GrubbyLittleRaccoon/QT19-T19E1-derivative/images/receiverComparison.png

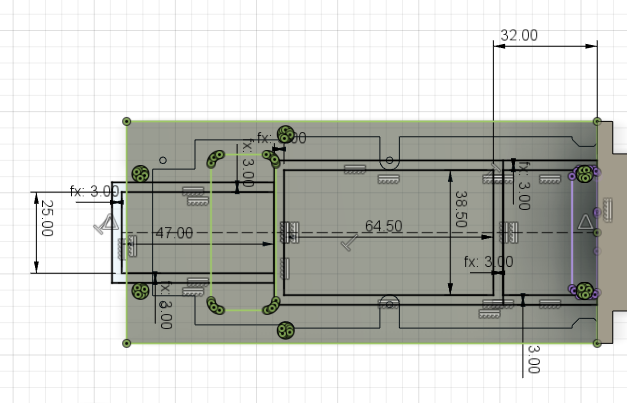
images/receiverComparison.png
