GrubbyLittleRaccoon/QT19-T19E1-derivative/qt19 stl files/Cages/Oldcages/Hy-Con-GammaMajor_Main_iFlightXE_PRO_9.5mm_covered.stl

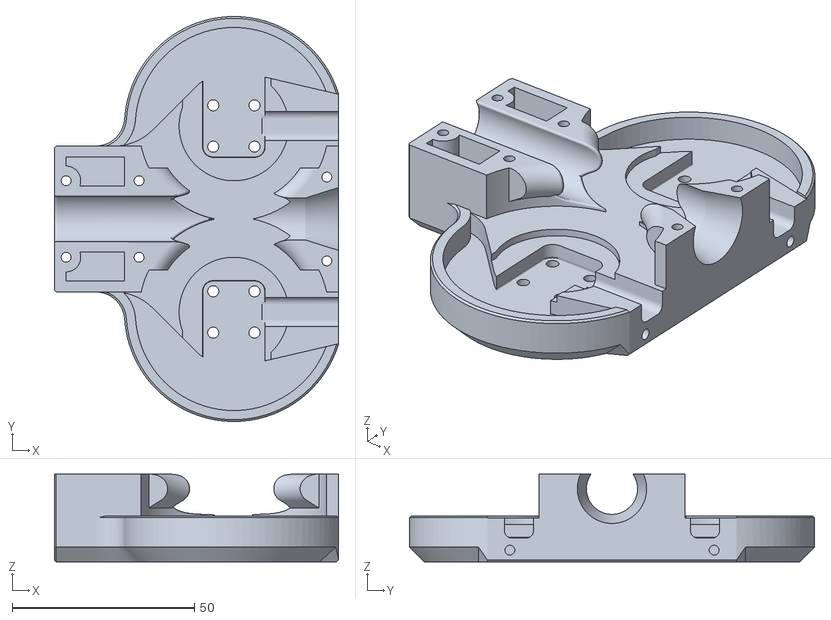
[picture p24: CAD file, 2022-11-29]
qt19 stl files/Cages/Oldcages/Hy-Con-GammaMajor_Main_iFlightXE_PRO_9.5mm_covered.stl
78.0 x 111.1 x 24.0
