GrubbyLittleRaccoon/QT19-T19E1-derivative/qt19 stl files/Cages/Hy-Con-GammaMajor_Main_iFlight_pro_9.0_ready_bcar.stl

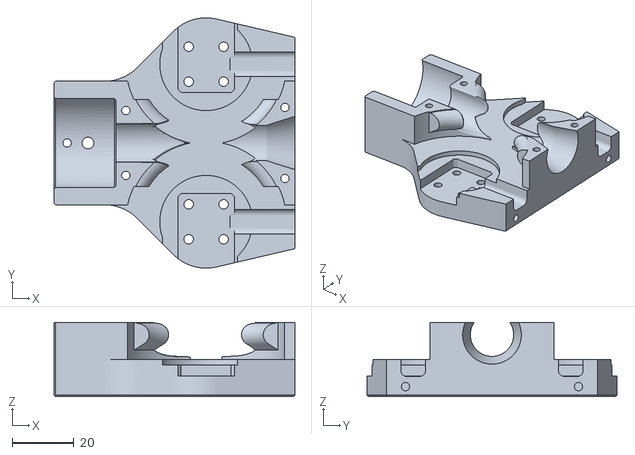
[picture p25: CAD file, 2023-09-17]
qt19 stl files/Cages/Hy-Con-GammaMajor_Main_iFlight_pro_9.0_ready_bcar.stl
78.0 x 81.0 x 24.0
