GrubbyLittleRaccoon/QT19-T19E1-derivative/qt19 stl files/Receiver/main receiver picatinny rail.stl

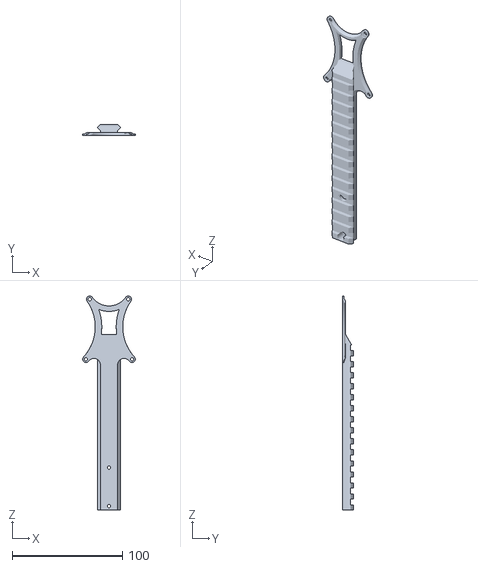
[picture p26: CAD file, 2022-11-29]
qt19 stl files/Receiver/main receiver picatinny rail.stl
48.0 x 10.3 x 194.5
