GrubbyLittleRaccoon/QT19-T19E1-derivative/GUI sight/sheetcurved.stl

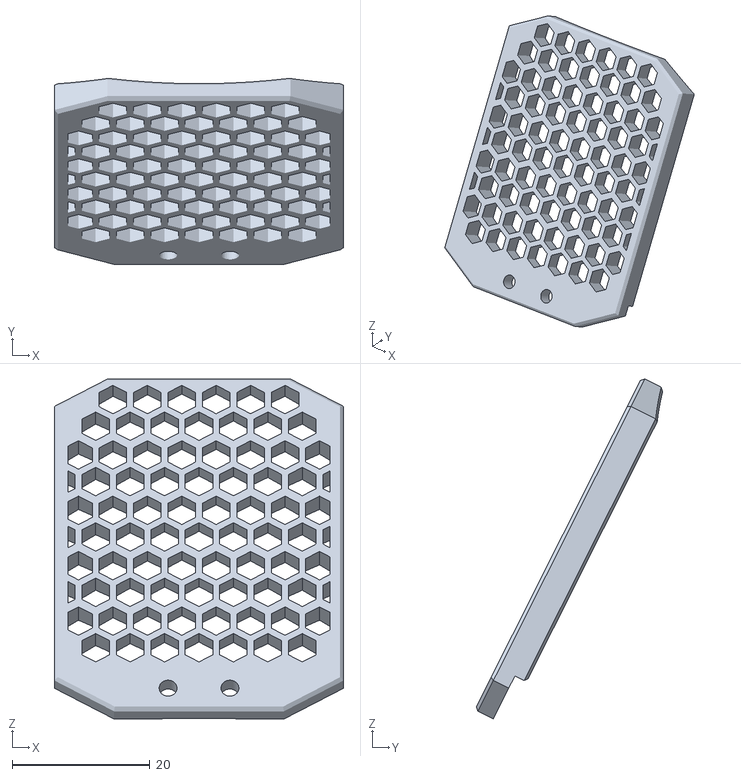
[picture p28: CAD file, 2022-11-29]
GUI sight/sheetcurved.stl
42.0 x 27.0 x 49.4
