GrubbyLittleRaccoon/QT19-T19E1-derivative/My stl edits/short breech edited no undercut.stl

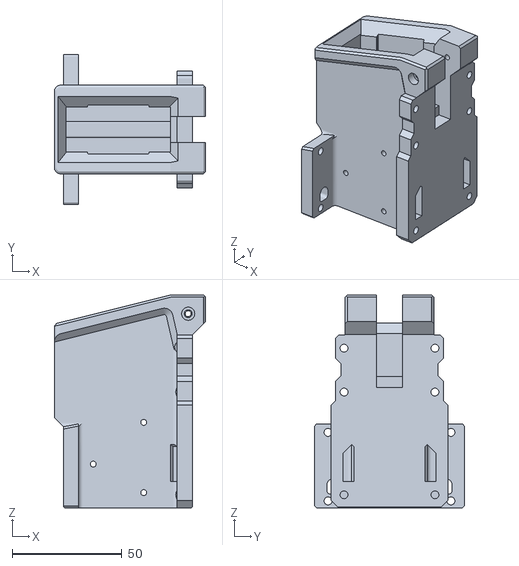
[picture p29: CAD file, 2022-11-29]
My stl edits/short breech edited no undercut.stl
69.0 x 68.4 x 97.0
