GrubbyLittleRaccoon/QT19-T19E1-derivative/qt19 stl files/Cages/Hy-Con-GammaMajor_toprail.stl

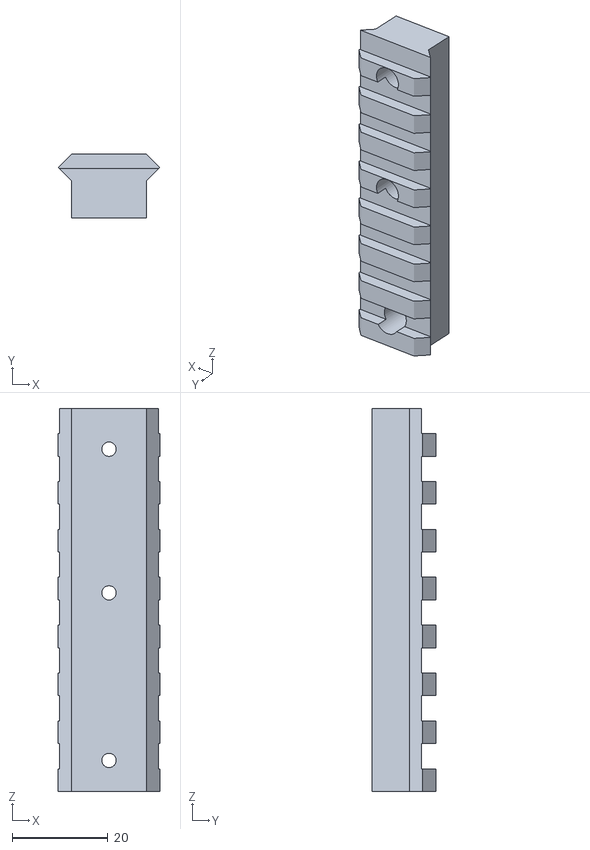
[picture p30: CAD file, 2023-09-17]
qt19 stl files/Cages/Hy-Con-GammaMajor_toprail.stl
21.2 x 13.3 x 80.0
