GrubbyLittleRaccoon/QT19-T19E1-derivative/qt19 stl files/Cages/Oldcages/Hy-Con_Wheels_iFlight_XE_PRO_9.0mm.stl

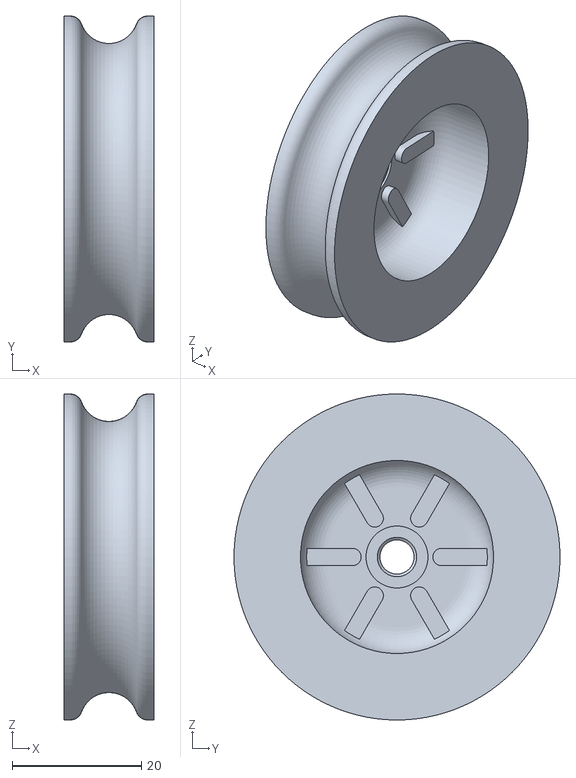
[picture p31: CAD file, 2022-11-29]
qt19 stl files/Cages/Oldcages/Hy-Con_Wheels_iFlight_XE_PRO_9.0mm.stl
14.0 x 50.5 x 50.5
