GrubbyLittleRaccoon/QT19-T19E1-derivative/qt19 stl files/Grip/QT19_Trigger_spaced.stl

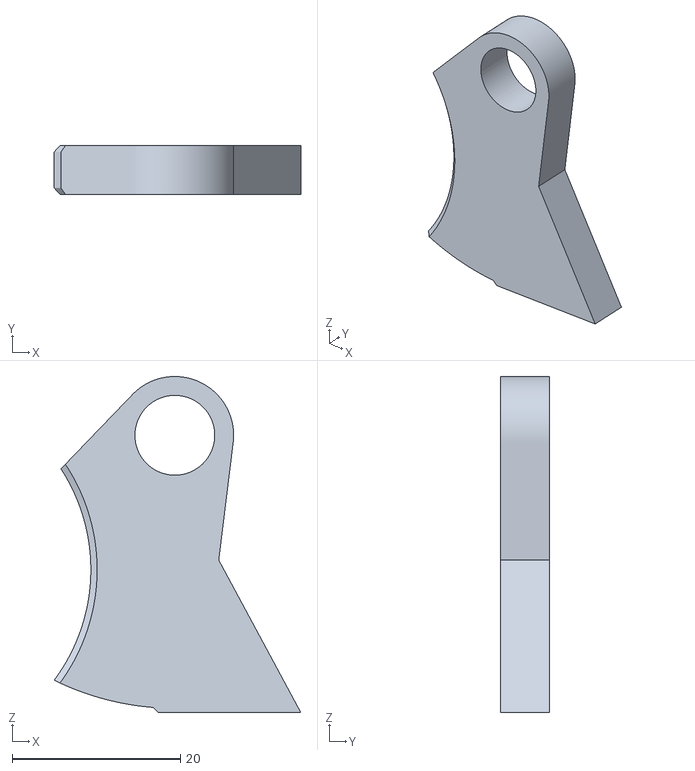
[picture p32: CAD file, 2023-09-17]
qt19 stl files/Grip/QT19_Trigger_spaced.stl
29.4 x 5.80 x 40.0
