GrubbyLittleRaccoon/QT19-T19E1-derivative/qt19 stl files/Magwell breech/QT19_ShortMagRelease_spaced.stl

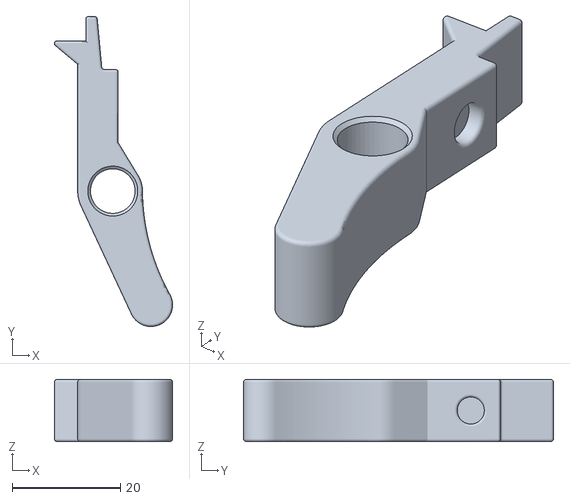
[picture p33: CAD file, 2023-09-17]
qt19 stl files/Magwell breech/QT19_ShortMagRelease_spaced.stl
21.9 x 57.4 x 11.5
