GrubbyLittleRaccoon/QT19-T19E1-derivative/qt19 stl files/Receiver/magreleaseblock.stl

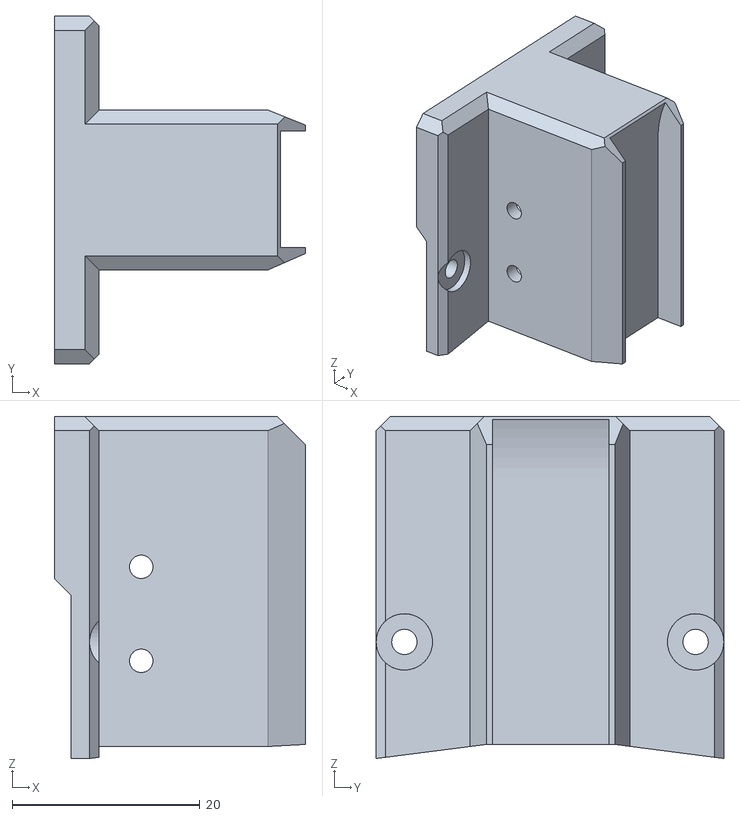
[picture p34: CAD file, 2023-09-19]
qt19 stl files/Receiver/magreleaseblock.stl
26.8 x 37.0 x 36.4
