GrubbyLittleRaccoon/QT19-T19E1-derivative/qt19 stl files/Top covers - probably redo these/polycarb_cover_cutguide.stl

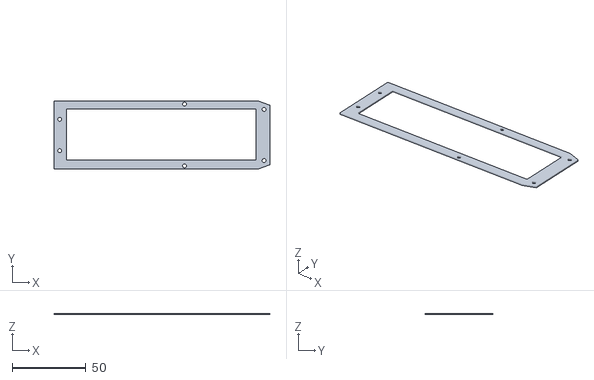
[picture p35: CAD file, 2022-11-29]
qt19 stl files/Top covers - probably redo these/polycarb_cover_cutguide.stl
146.5 x 46.4 x 1.00
