GrubbyLittleRaccoon/QT19-T19E1-derivative/GUI sight/top02.stl

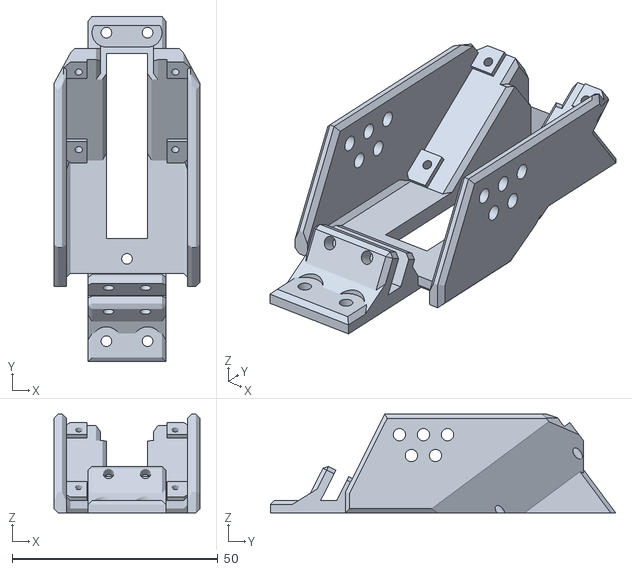
[picture p36: CAD file, 2022-11-29]
GUI sight/top02.stl
35.5 x 84.0 x 24.0
