GrubbyLittleRaccoon/QT19-T19E1-derivative/My stl edits/stock base.stl

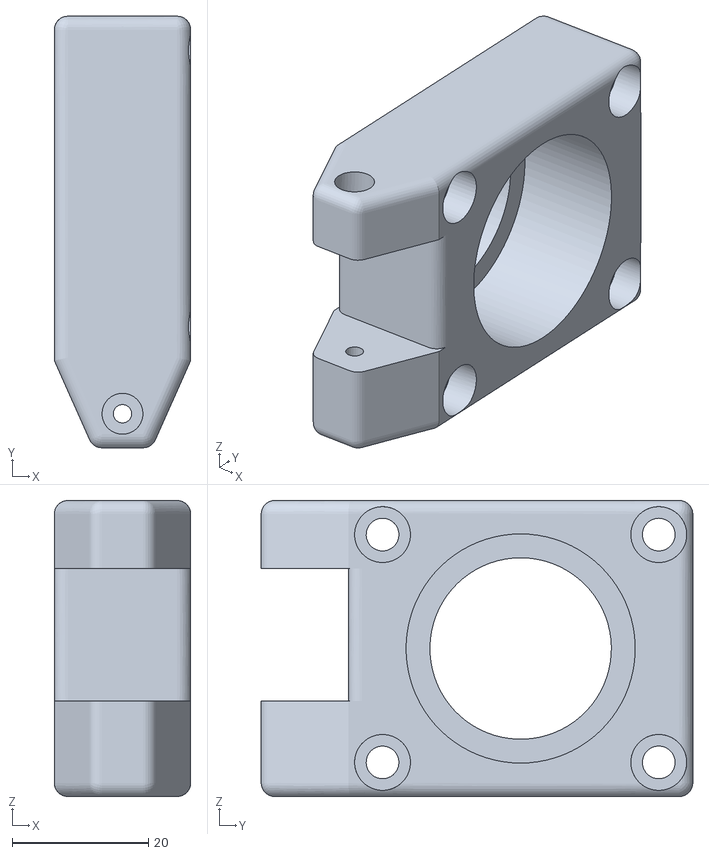
[picture p37: CAD file, 2022-11-29]
My stl edits/stock base.stl
20.0 x 63.3 x 43.4
