GrubbyLittleRaccoon/QT19-T19E1-derivative/qt19 stl files/Cages/Hy-Con-GammaMajor_Cover_BR2207S_undercut_bcar.stl

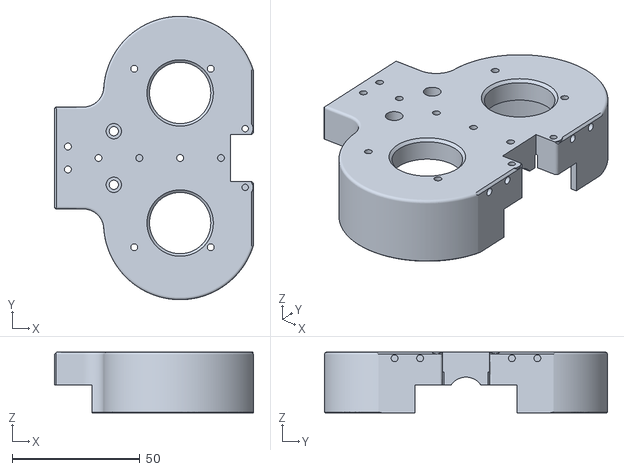
[picture p38: CAD file, 2023-09-17]
qt19 stl files/Cages/Hy-Con-GammaMajor_Cover_BR2207S_undercut_bcar.stl
78.0 x 111.1 x 23.8
