GrubbyLittleRaccoon/QT19-T19E1-derivative/qt19 stl files/Grip/QT19_Trigger_spacer.stl

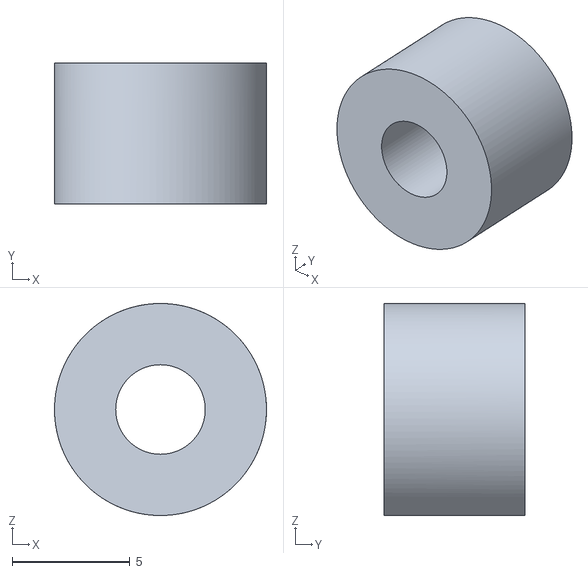
[picture p39: CAD file, 2023-09-17]
qt19 stl files/Grip/QT19_Trigger_spacer.stl
9.00 x 6.00 x 9.00
