GrubbyLittleRaccoon/QT19-T19E1-derivative/qt19 stl files/Magwell breech/QT19_ShortMagRelease_spacer.stl

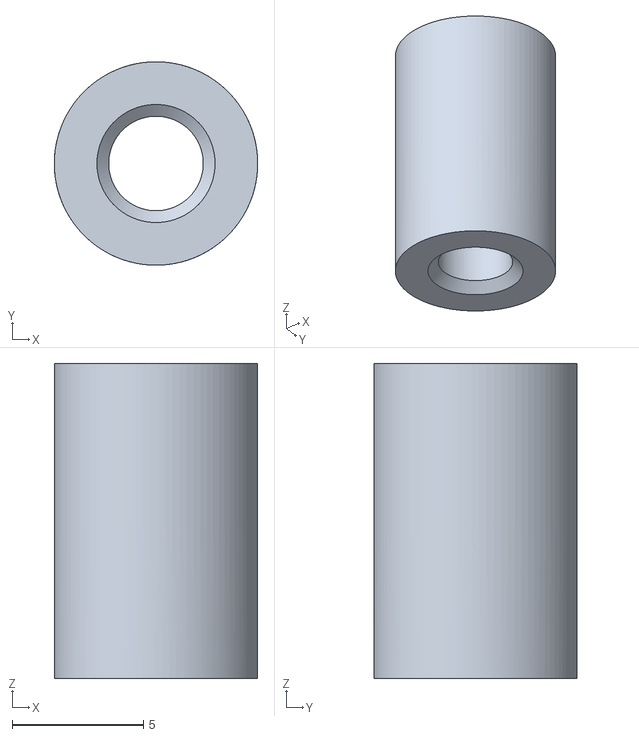
[picture p40: CAD file, 2023-09-17]
qt19 stl files/Magwell breech/QT19_ShortMagRelease_spacer.stl
7.75 x 7.75 x 12.0
