GrubbyLittleRaccoon/QT19-T19E1-derivative/qt19 stl files/Receiver/hexagonal solenoid pusher.stl

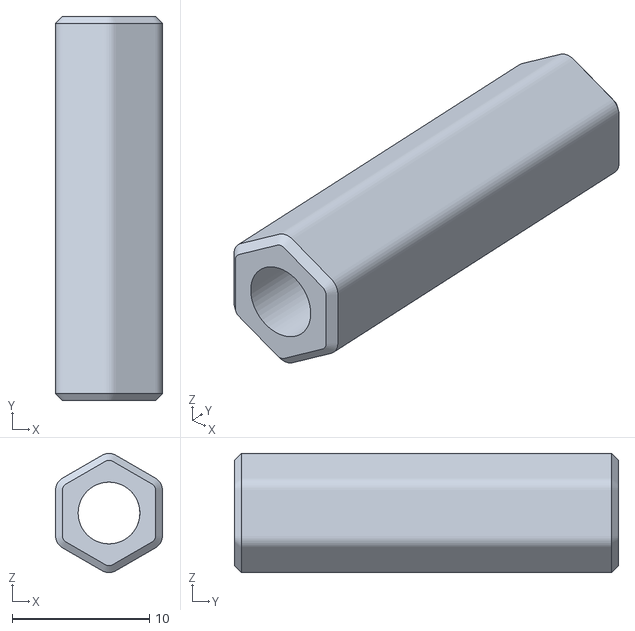
[picture p41: CAD file, 2022-11-29]
qt19 stl files/Receiver/hexagonal solenoid pusher.stl
7.79 x 28.0 x 8.69
