GrubbyLittleRaccoon/QT19-T19E1-derivative/qt19 stl files/Stock/printed stock tube pt1.stl

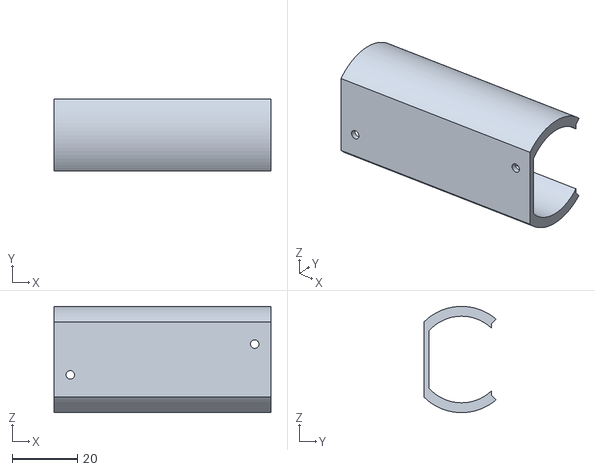
[picture p42: CAD file, 2022-11-29]
qt19 stl files/Stock/printed stock tube pt1.stl
66.4 x 22.1 x 32.5
