GrubbyLittleRaccoon/QT19-T19E1-derivative/qt19 stl files/Top covers - probably redo these/solenoid cover.stl

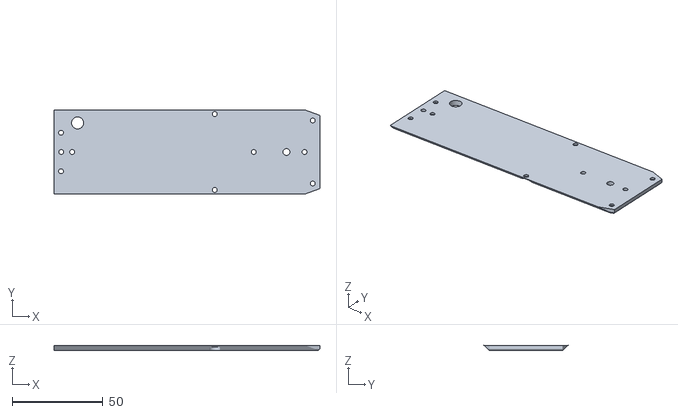
[picture p43: CAD file, 2022-11-29]
qt19 stl files/Top covers - probably redo these/solenoid cover.stl
146.5 x 46.4 x 3.00
