GrubbyLittleRaccoon/QT19-T19E1-derivative/GUI sight/sheet.stl

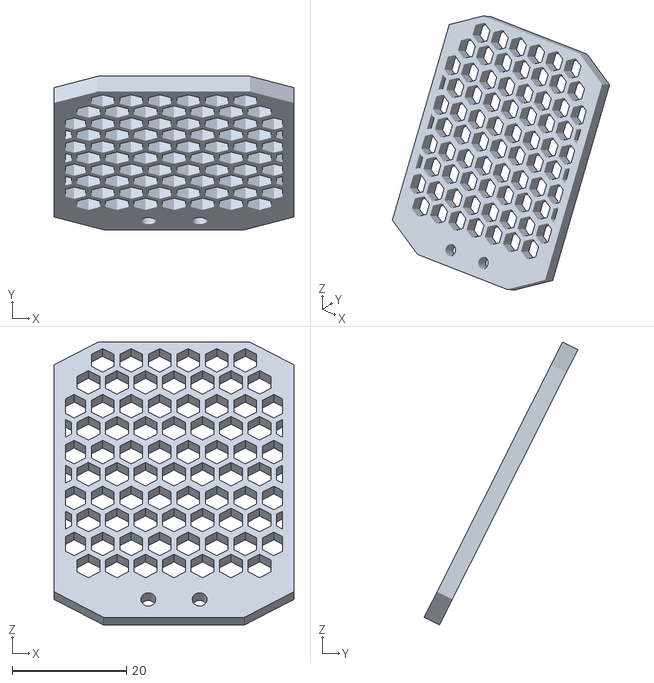
[picture p44: CAD file, 2022-11-29]
GUI sight/sheet.stl
42.0 x 26.9 x 49.6
