GrubbyLittleRaccoon/QT19-T19E1-derivative/My stl edits/charging slider.stl

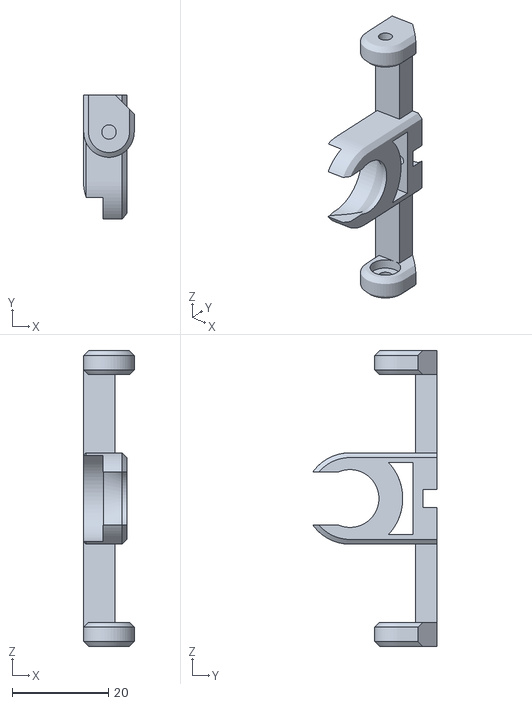
[picture p45: CAD file, 2022-11-29]
My stl edits/charging slider.stl
10.5 x 25.9 x 61.5
