GrubbyLittleRaccoon/QT19-T19E1-derivative/qt19 stl files/Cages/Oldcages/picatinny cage muzzle cosmetic barrel.stl

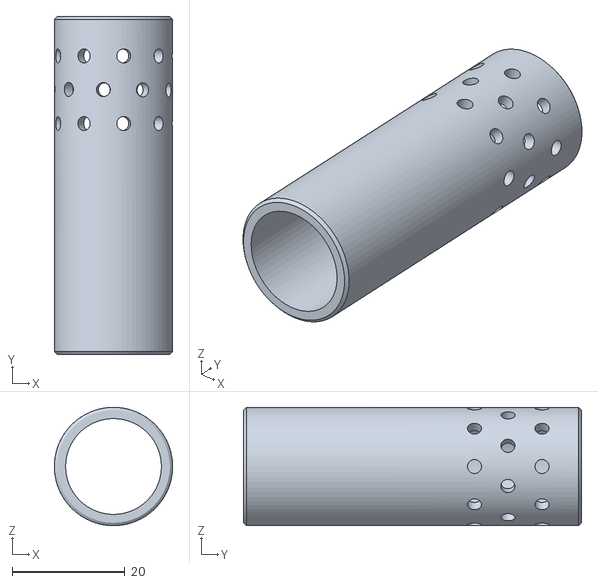
[picture p46: CAD file, 2022-11-29]
qt19 stl files/Cages/Oldcages/picatinny cage muzzle cosmetic barrel.stl
21.0 x 60.0 x 21.0
