GrubbyLittleRaccoon/QT19-T19E1-derivative/qt19 stl files/Grip/QT19_GripBase.stl

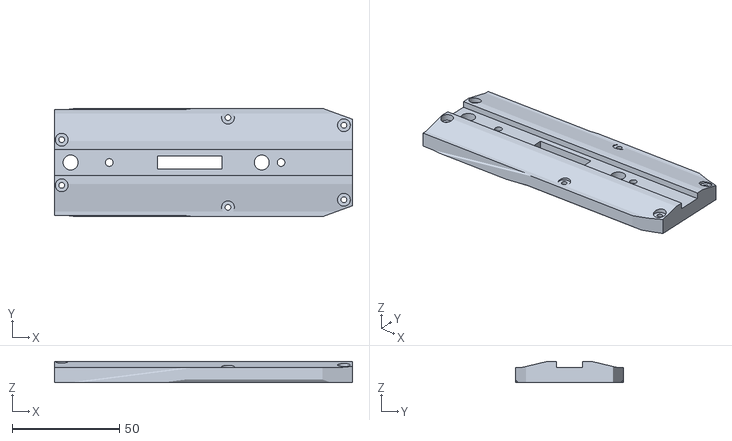
[picture p47: CAD file, 2022-11-29]
qt19 stl files/Grip/QT19_GripBase.stl
138.8 x 50.5 x 10.0
