GrubbyLittleRaccoon/QT19-T19E1-derivative/qt19 stl files/Magwell breech/QT19_ShortBreech.stl

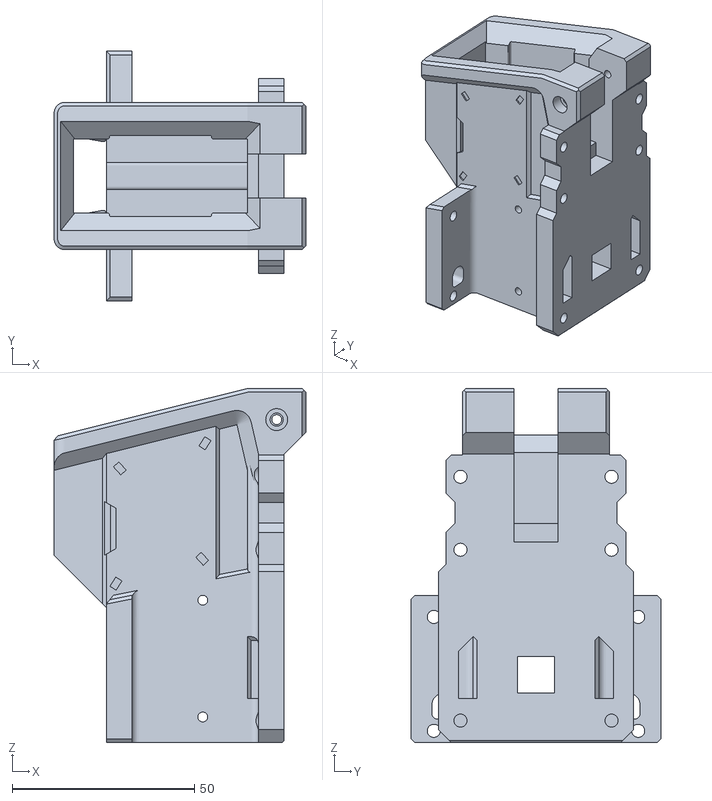
[picture p48: CAD file, 2022-11-29]
qt19 stl files/Magwell breech/QT19_ShortBreech.stl
69.0 x 68.4 x 97.0
