GrubbyLittleRaccoon/QT19-T19E1-derivative/qt19 stl files/Stock/QT19_Stock.stl

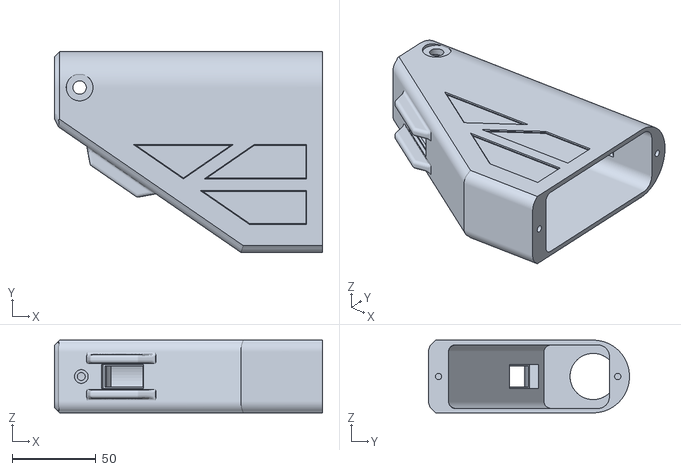
[picture p49: CAD file, 2022-11-29]
qt19 stl files/Stock/QT19_Stock.stl
160.0 x 120.0 x 43.4
