GrubbyLittleRaccoon/QT19-T19E1-derivative/qt19 stl files/Top covers - probably redo these/breech top cover 2.stl

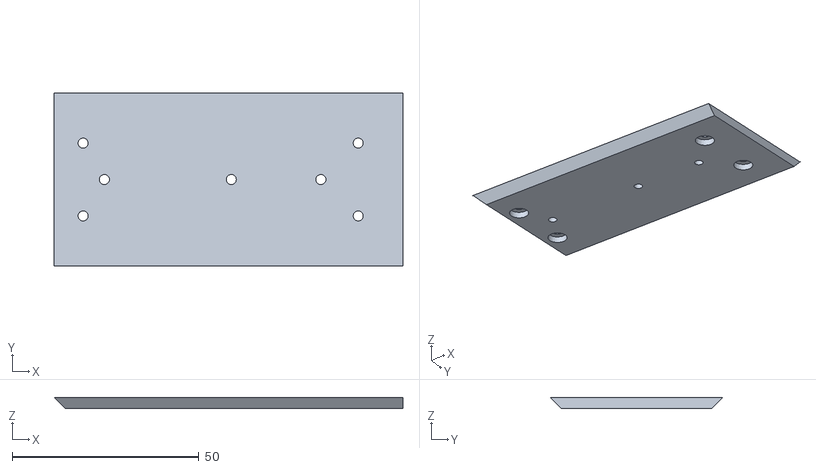
[picture p50: CAD file, 2022-11-29]
qt19 stl files/Top covers - probably redo these/breech top cover 2.stl
93.5 x 46.4 x 3.00
