GrubbyLittleRaccoon/QT19-T19E1-derivative/GUI sight/base02.stl

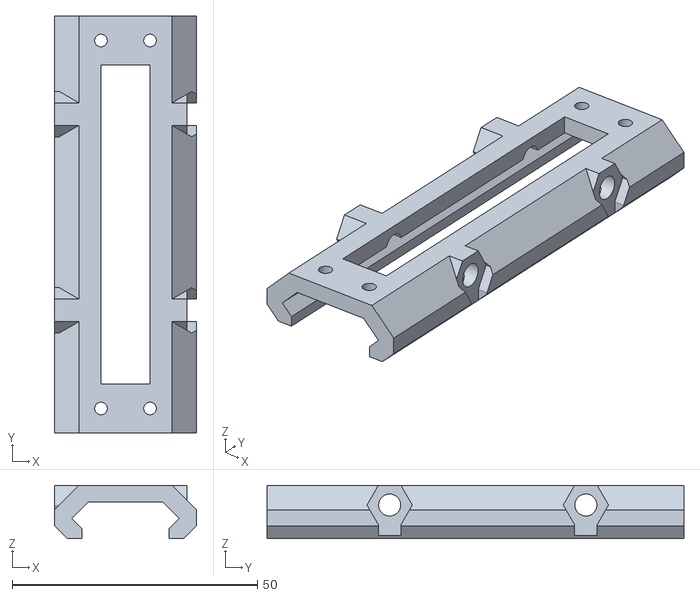
[picture p51: CAD file, 2022-11-29]
GUI sight/base02.stl
29.0 x 85.0 x 10.9
