GrubbyLittleRaccoon/QT19-T19E1-derivative/My stl edits/charging nub.stl

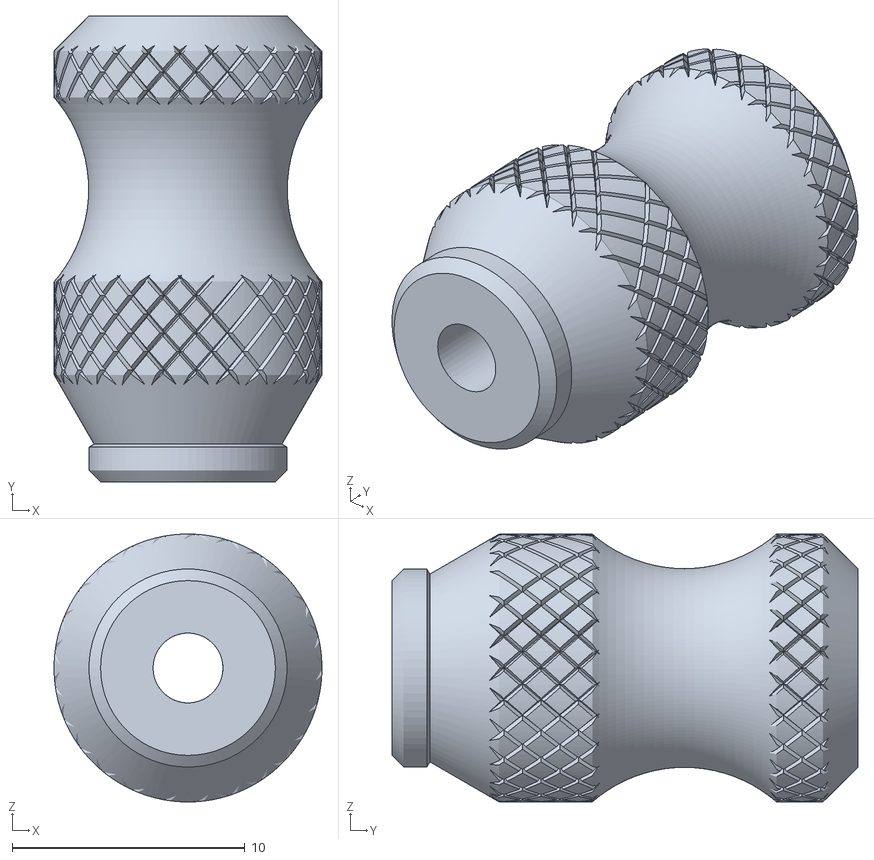
[picture p52: CAD file, 2022-11-29]
My stl edits/charging nub.stl
11.5 x 20.0 x 11.5
