GrubbyLittleRaccoon/QT19-T19E1-derivative/qt19 stl files/Cages/Hy-Con-insert muzzle.stl

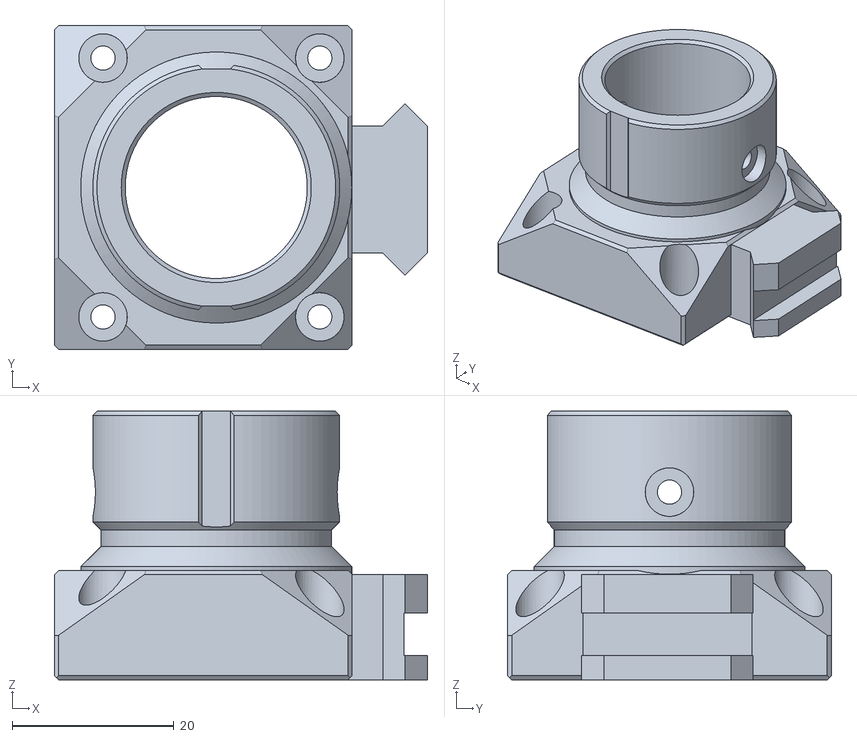
[picture p53: CAD file, 2023-09-17]
qt19 stl files/Cages/Hy-Con-insert muzzle.stl
46.1 x 40.0 x 33.2
