GrubbyLittleRaccoon/QT19-T19E1-derivative/qt19 stl files/Grip/QT19_GripPanelRight.stl

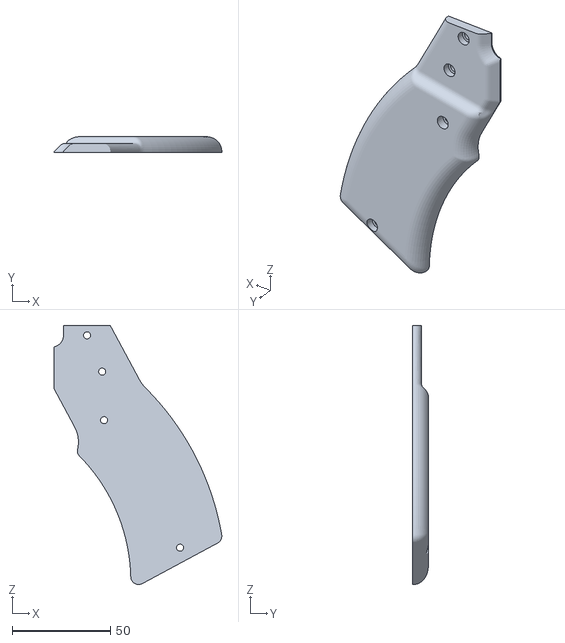
[picture p55: CAD file, 2022-11-29]
qt19 stl files/Grip/QT19_GripPanelRight.stl
85.3 x 8.00 x 131.7
