GrubbyLittleRaccoon/QT19-T19E1-derivative/qt19 stl files/Magwell breech/QT19_Short_Wirecover.stl

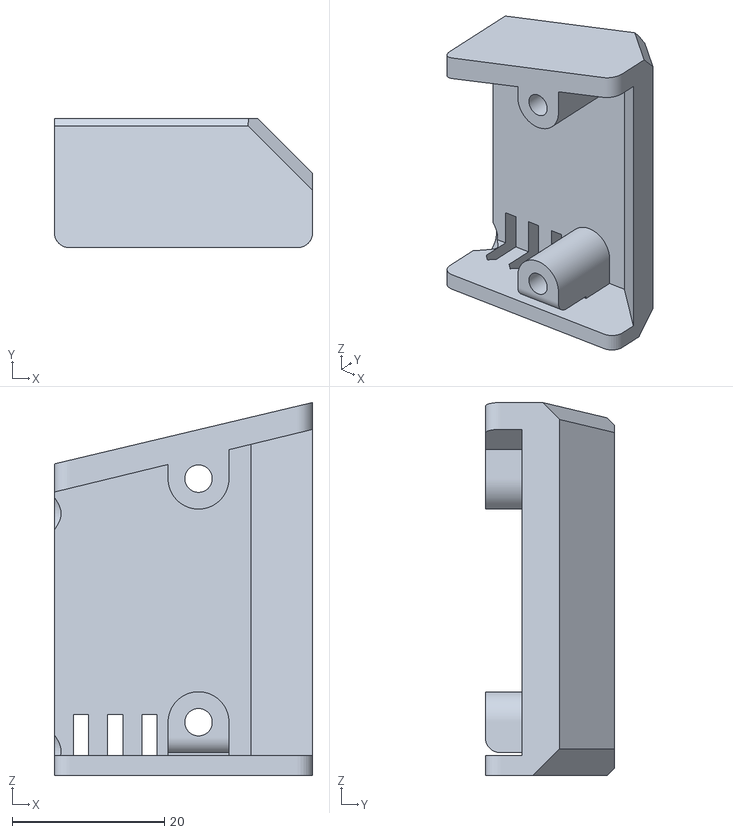
[picture p56: CAD file, 2022-11-29]
qt19 stl files/Magwell breech/QT19_Short_Wirecover.stl
34.0 x 17.0 x 49.0
