GrubbyLittleRaccoon/QT19-T19E1-derivative/qt19 stl files/Receiver/solenoid upper reciever.stl

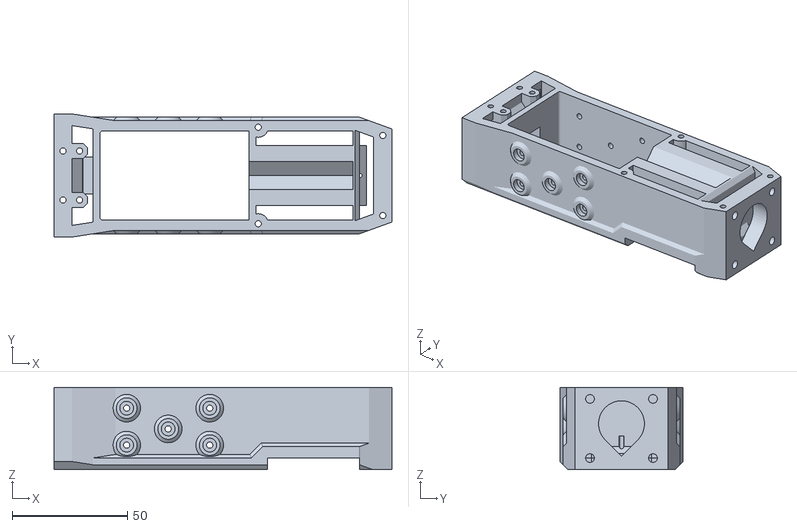
[picture p57: CAD file, 2022-11-29]
qt19 stl files/Receiver/solenoid upper reciever.stl
146.5 x 53.4 x 35.6
