GrubbyLittleRaccoon/QT19-T19E1-derivative/qt19 stl files/Stock/printed stock tube pt3.stl

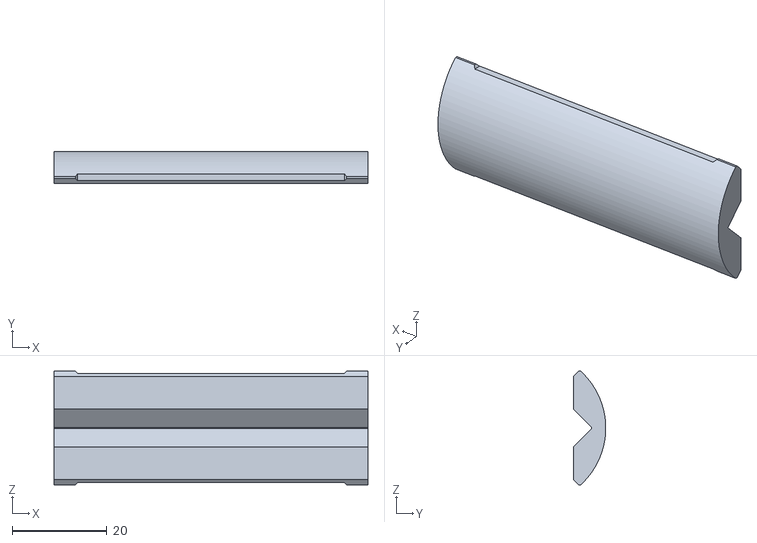
[picture p58: CAD file, 2022-11-29]
qt19 stl files/Stock/printed stock tube pt3.stl
66.4 x 6.87 x 24.0
