GrubbyLittleRaccoon/QT19-T19E1-derivative/qt19 stl files/Top covers - probably redo these/breech top cover.stl

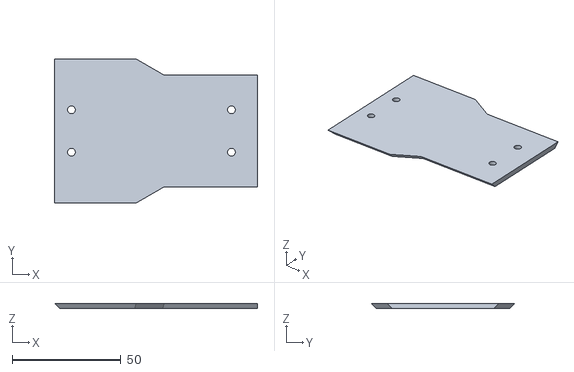
[picture p59: CAD file, 2022-11-29]
qt19 stl files/Top covers - probably redo these/breech top cover.stl
93.5 x 66.4 x 2.50
