GrubbyLittleRaccoon/QT19-T19E1-derivative/My stl edits/stock point.stl

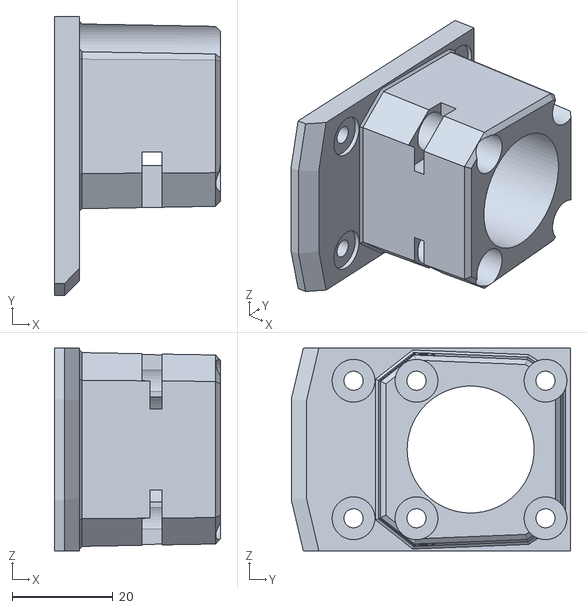
[picture p60: CAD file, 2022-11-29]
My stl edits/stock point.stl
33.0 x 55.5 x 40.3
