GrubbyLittleRaccoon/QT19-T19E1-derivative/qt19 stl files/Cages/Hy-Con_QT19 undercut undercage rail.stl

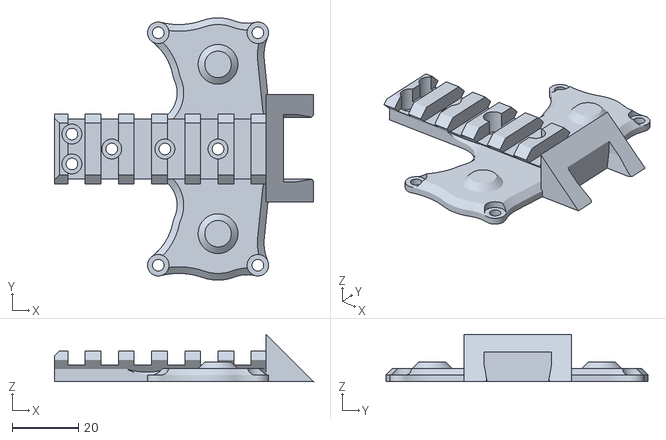
[picture p61: CAD file, 2022-11-29]
qt19 stl files/Cages/Hy-Con_QT19 undercut undercage rail.stl
78.0 x 79.0 x 14.3
