GrubbyLittleRaccoon/QT19-T19E1-derivative/qt19 stl files/Cages/Oldcages/Hy-Con-GammaMajor_Cover_iFlightXE_PRO_undercut.stl

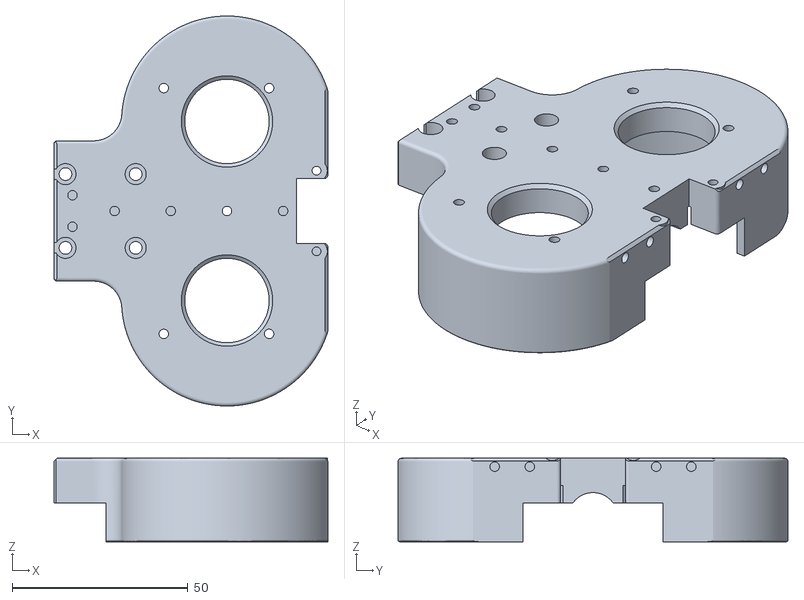
[picture p62: CAD file, 2022-11-29]
qt19 stl files/Cages/Oldcages/Hy-Con-GammaMajor_Cover_iFlightXE_PRO_undercut.stl
78.0 x 111.1 x 23.8
