GrubbyLittleRaccoon/QT19-T19E1-derivative/qt19 stl files/Grip/QT19_GripFrame.stl

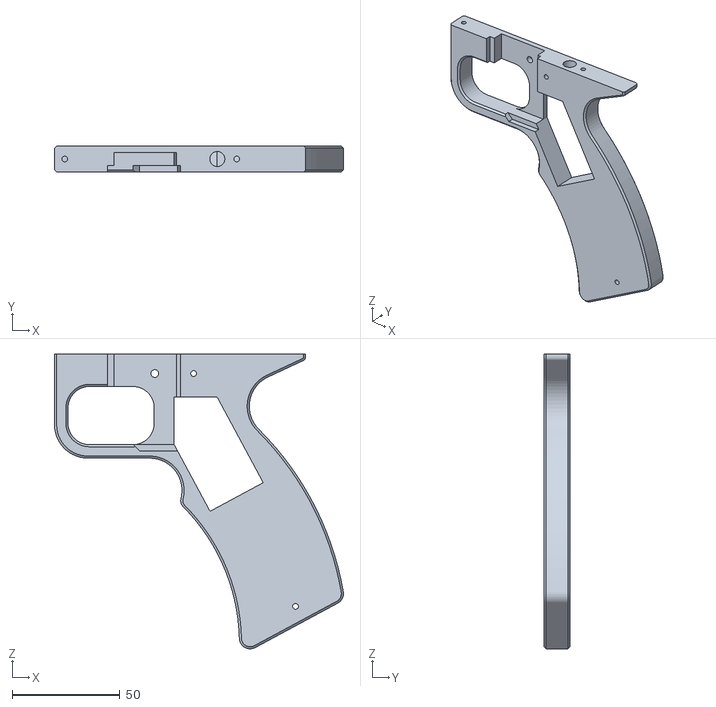
[picture p63: CAD file, 2022-11-29]
qt19 stl files/Grip/QT19_GripFrame.stl
134.0 x 12.0 x 136.7
