GrubbyLittleRaccoon/QT19-T19E1-derivative/qt19 stl files/Receiver/solenoid lower receiver.stl

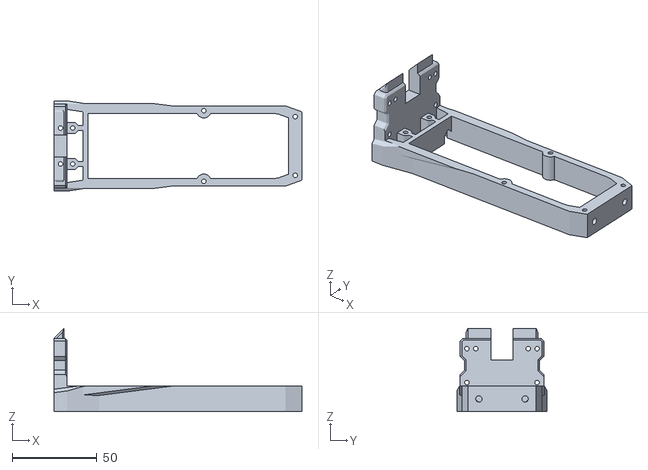
[picture p64: CAD file, 2022-11-29]
qt19 stl files/Receiver/solenoid lower receiver.stl
146.5 x 53.4 x 49.2
