GrubbyLittleRaccoon/QT19-T19E1-derivative/qt19 stl files/Stock/QT19_StockBase.stl

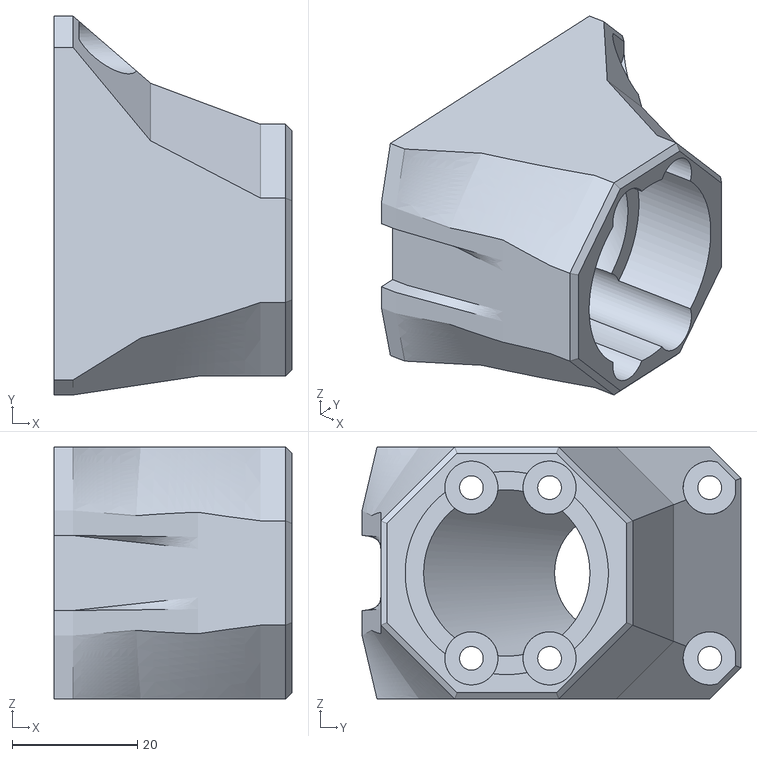
[picture p65: CAD file, 2022-11-29]
qt19 stl files/Stock/QT19_StockBase.stl
38.0 x 60.6 x 40.3
