GrubbyLittleRaccoon/QT19-T19E1-derivative/My stl edits/drive cover.stl

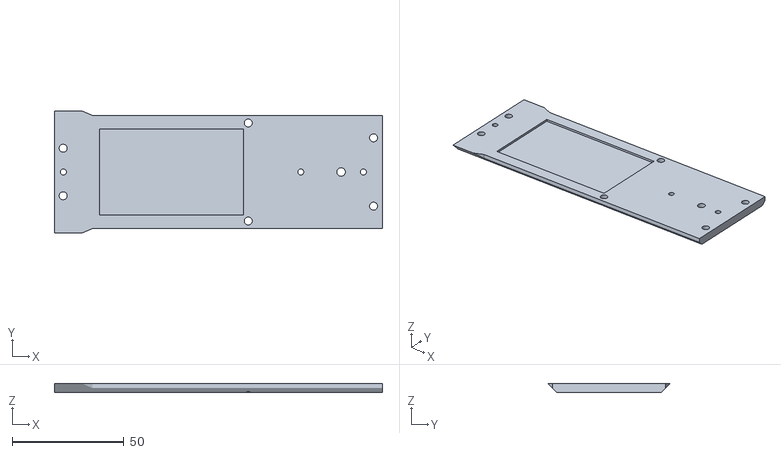
[picture p66: CAD file, 2022-11-29]
My stl edits/drive cover.stl
146.5 x 54.6 x 4.00
