GrubbyLittleRaccoon/QT19-T19E1-derivative/qt19 stl files/Cages/Oldcages/Hy-Con gamma major top picatinny rail.stl

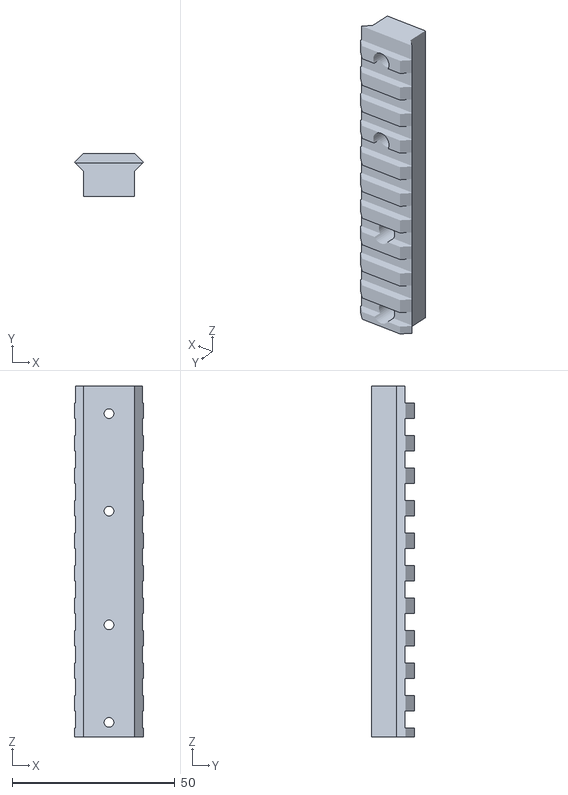
[picture p67: CAD file, 2022-11-29]
qt19 stl files/Cages/Oldcages/Hy-Con gamma major top picatinny rail.stl
21.2 x 13.3 x 108.0
