GrubbyLittleRaccoon/QT19-T19E1-derivative/qt19 stl files/Stock/M4 eyelet.stl

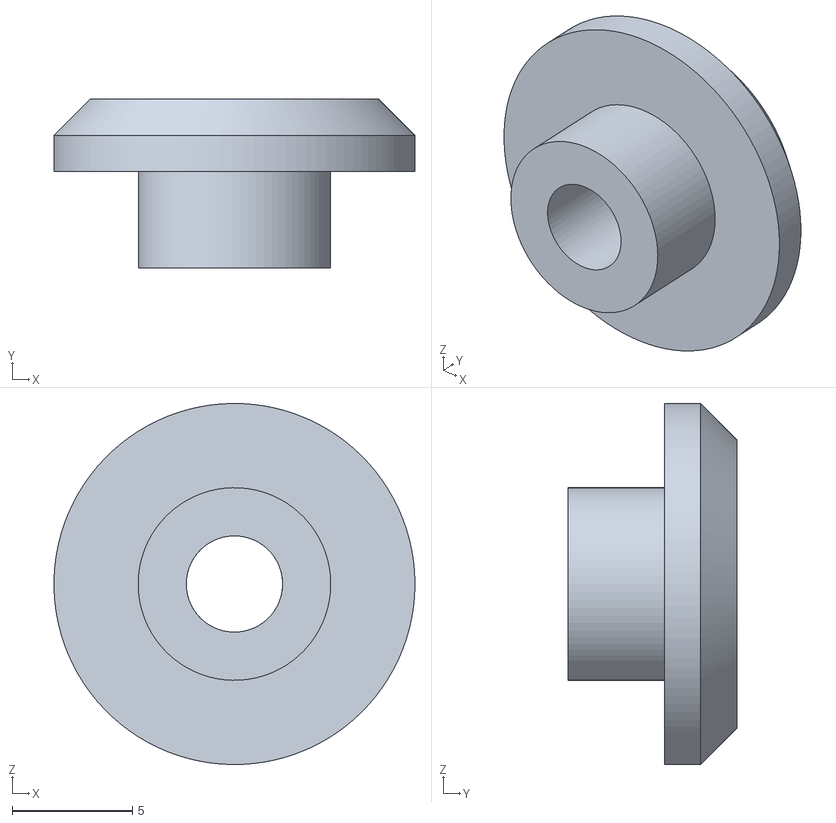
[picture p68: CAD file, 2022-11-29]
qt19 stl files/Stock/M4 eyelet.stl
15.0 x 7.00 x 15.0
