GrubbyLittleRaccoon/QT19-T19E1-derivative/qt19 stl files/Stock/printed stock tube pt2.stl

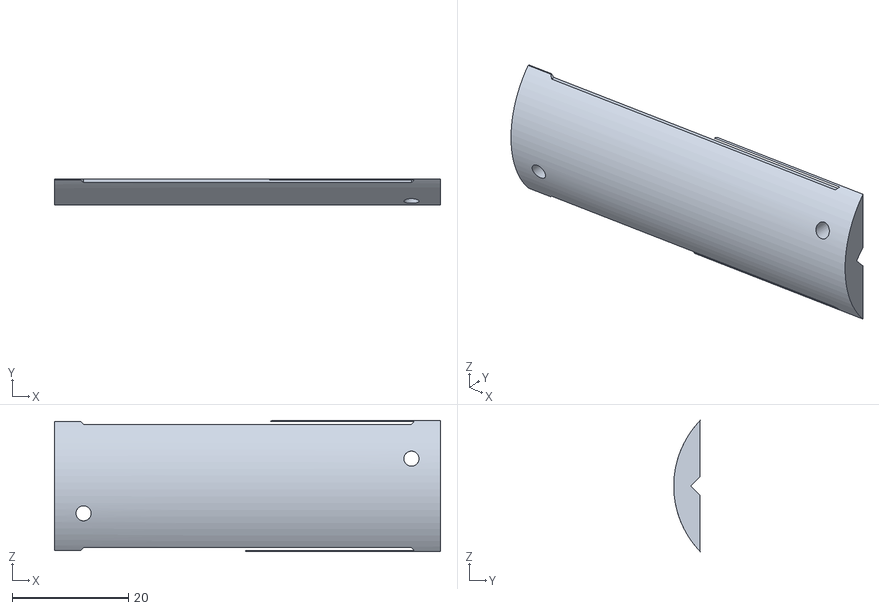
[picture p69: CAD file, 2022-11-29]
qt19 stl files/Stock/printed stock tube pt2.stl
66.4 x 4.55 x 22.6
