GrubbyLittleRaccoon/QT19-T19E1-derivative/qt19 stl files/Cages/Oldcages/Hy-Con picatinny cage muzzle 20mm.stl

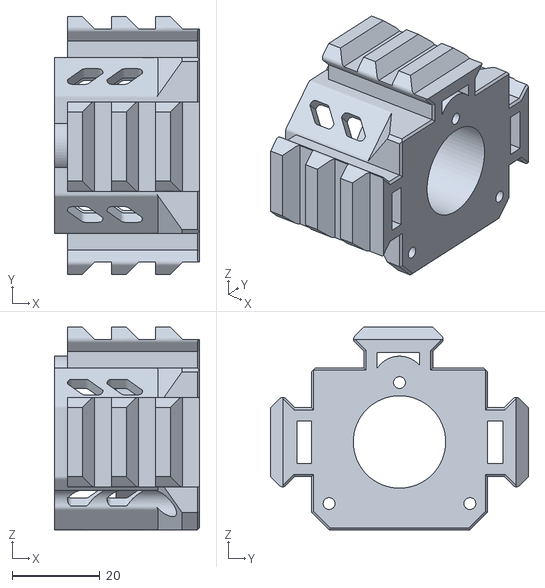
[picture p70: CAD file, 2022-11-29]
qt19 stl files/Cages/Oldcages/Hy-Con picatinny cage muzzle 20mm.stl
33.0 x 58.6 x 46.1
