GrubbyLittleRaccoon/QT19-T19E1-derivative/qt19 stl files/Stock/GryphonSlingmountv2 - scaleup28%.stl

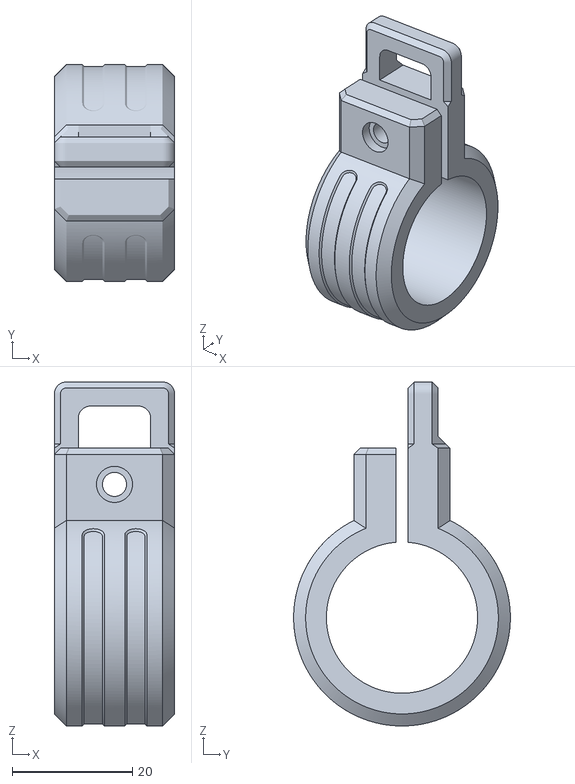
[picture p71: CAD file, 2022-11-29]
qt19 stl files/Stock/GryphonSlingmountv2 - scaleup28%.stl
20.0 x 36.0 x 57.1
