GrubbyLittleRaccoon/QT19-T19E1-derivative/(list of files, cad)

Other CAD files:
qt19 stl files/Grip/QT19_GripPanelLeft.stl
qt19 stl files/Stock/M4 thumbscrew.stl
