GrubbyLittleRaccoon/QT19-T19E1-derivative/(commit log)

2022-11-20 Fixing interrupt for burst
    Added state monitoring/switching to detect press from release, added extra spin down time
2022-11-29 Uploading STL files
    [GryphonSlingmountv2 - scaleup28%.stl, Hy-Con-GammaMajor_Cover_BR2207S_undercut.stl, barrel.stl, breech cover.stl, breech magwell cover.stl, cage muzzle.stl, charging nub.stl, charging slider.stl]
2022-11-29 uploading GUI sights (latest only)
    [base02.stl, sheet.stl, sheetcurved.stl, top02.stl]
2023-06-17 Update qt19software.ino
    Removed the gui sight, converted to regular counter/display
    Fixed rising edge trigger issue
    [qt19software.ino]
2023-09-10 cleanup folder hierarchy, convert doc to markdown
    [GryphonSlingmountv2 - scaleup28%.stl, Hy-Con gamma major top picatinny rail.stl, Hy-Con picatinny cage muzzle 20mm.stl, Hy-Con-GammaMajor_Cover_iFlightXE_PRO_undercut.stl, Hy-Con-GammaMajor_Main_iFlightXE_PRO_9.0mm_covered.stl, Hy-Con-GammaMajor_Main_iFlightXE_PRO_9.5mm_covered.stl, Hy-Con_QT19 undercut undercage rail.stl, Hy-Con_Wheels_iFlight_XE_PRO_9.0mm.stl]
2023-09-17 moved image files, added spaced trigger/release, cleanup naming, rename md to README
    [Q19_Short_Wirecover.stl, QT19_GripBase.stl, QT19_GripFrame.stl, QT19_GripPanelLeft.stl, QT19_GripPanelRight.stl, QT19_ShortBreech.stl, QT19_ShortMagRelease_spaced.stl, QT19_ShortMagRelease_spacer.stl]
2023-09-17 moved insert cages images to separate repo, updated cages files, renamed for consistency
    [Hy-Con gamma major top picatinny rail.stl, Hy-Con picatinny cage muzzle 20mm.stl, Hy-Con-GammaMajor_Cover_BR2207S_undercut_bcar.stl, Hy-Con-GammaMajor_Cover_iFlightXE_PRO_undercut.stl, Hy-Con-GammaMajor_Main_iFlightXE_PRO_9.0mm_covered.stl, Hy-Con-GammaMajor_Main_iFlightXE_PRO_9.5mm_covered.stl, Hy-Con-GammaMajor_Main_iFlight_pro_9.0_ready_bcar.stl, Hy-Con-GammaMajor_toprail.stl]
2023-09-17 bolts/screws, solenoid note, magswitch pic
2023-09-19 Documentation, cleaner magreleaseblock
    [magreleaseblock.stl]
